cheeserust/final_project/주행파트 일지.md

# 작업 일지 (Work Log)

## 7/6
### 오늘 한 것
1. cpu 오버로드 에러 발견
```
   [component_container_isolated-1] [WARN] [1783338867.642356056] [bt_navigator_navigate_to_pose_rclcpp_node]: Timed out while waiting for action server to acknowledge goal request for compute_path_to_pose
[component_container_isolated-1] [ERROR] [1783338867.663267694] [bt_navigator_navigate_to_pose_rclcpp_node]: Failed to get result for follow_path in node halt!
[component_container_isolated-1] [WARN] [1783338867.663639029] [bt_navigator]: [navigate_to_pose] [ActionServer] Aborting handle.
[component_container_isolated-1] [ERROR] [1783338867.664488179] [bt_navigator]: Goal failed
[component_container_isolated-1] [WARN] [1783338867.671340638] [controller_server]: Control loop missed its desired rate of 20.0000 Hz. Current loop rate is 12.3509 Hz.
[component_container_isolated-1] [INFO] [1783338867.671417620] [controller_server]: Cancellation was successful. Stopping the robot.
[component_container_isolated-1] [INFO] [1783338867.671439212] [controller_server]: [follow_path] [ActionServer] Client requested to cancel the goal. Cancelling.
```
2. 합친 코드 엘리베이터 타는것까지 테스트 완료
3. 파라미터 수정해서 주행 안정화 --> 벽에 붙는 현상 해소

### 내일 할 것
1. 내리는거 시퀀스 수정
2. 코드 최적화

## 7/5
### 오늘 한 것
1. 코드 합쳤다
2. local costmap 뒤집히는 억까 풀려고 했다 근데 못풀었다

### 내일 할 것
1. 코드 full scenario 테스트해보기
2. 하차 marker들 좌표 & yaw값 floor markers에 넣기
3. 디버깅용 로그 넣기 (필요하면)
4. local costmap 계속 뒤집혀있으면 다시 sllidar_ros2 깔아서 해보기

## 7/4
### 지금까지 한것
1. 엘베 하차 후 회전 동작 구현 (살짝 손봐야함)
2. 아르코마커 servoing
3. 층에서 좌표로 navigation 기능 구현

### 할거
1. 코드합치기

## 6/30
### 오늘 한 것
1. pinky_delivery 의 앨베 타고 내리는 로직 수정
2. 맵 스위치 로직 수정 --> map_switcher 가 더이상 카메라를 사용하지 않음, /floor/check 토픽을 구독하고 있다가 맵이 바뀐거 감지되면 교체
3. 빅핑키 1.5층 만들었음
4. 층 주행 패키지 + 층간이동 패키지 코드 합침

### 내일 할 것
1. 합친 코드로 주행 해보기
2. LLM으로 주행 해보기
3. 중앙 서버에 뭐 올려야 하는지 의논

## 6/29
### 오늘 한 것
1. 엘리베이터 문 열리고 닫히고 마커인식해서 cmd_vel 로 주행 하는거 확인
2. 미리 정해놓은 key 좌표로 주행하는거 구현

### 내일 할 것
1. 패키지 만들고 driving flooring 합치기
2. 1.5층 만들기
