cheeserust/final_project/gripper_description/docs/dimensions/finger_dimensions.txt

==========================================
Finger Dimensions
==========================================

Finger Width            : 30.2 mm
Finger Overall Length   : 58.9 mm

Middle Link Length      : 54.0 mm
Middle Link Face Length : 51.0 mm

Finger Tip Length       : 20.0 mm
Finger End Length       : 22.5 mm
Finger Face Length      : 56.4 mm

Bearing Pocket Height   : 3.8 mm
