cheeserust/final_project/gripper_description/docs/dimensions/reference_dimensions.txt

==========================================
Reference Dimensions
==========================================

Finger Tip ↔ End Shaft Distance      : 108.7 mm
Finger Tip ↔ Middle Shaft Distance   : 46.3 mm

Joint Center Distance                : 63.5 mm

Base Offset                          : 27.3 mm

Base Shaft Distance #1               : 80.5 mm
Base Shaft Distance #2               : 80.7 mm
Base Shaft Distance #3               : 81.8 mm
