cheeserust/final_project/imgs/system_architecture.png

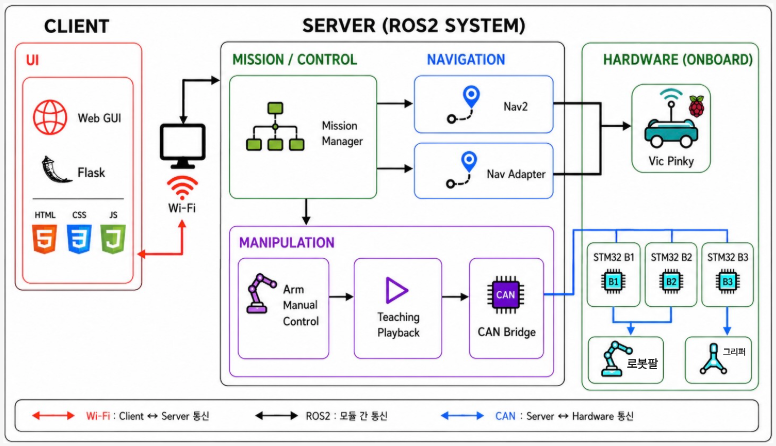
imgs/system_architecture.png
