cheeserust/final_project/gripper_description/meshes/stl/end_effector/link_connecting_part.stl

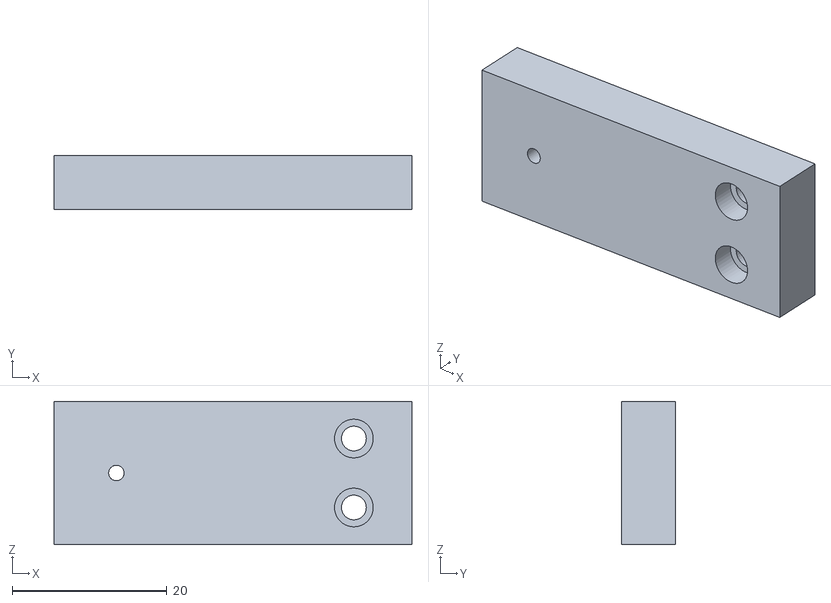
[picture p4: CAD file, 2026-07-07]
gripper_description/meshes/stl/end_effector/link_connecting_part.stl
46.2 x 7.00 x 18.5
