cheeserust/final_project/gripper_description/meshes/stl/shaft/shaft_3mm.stl

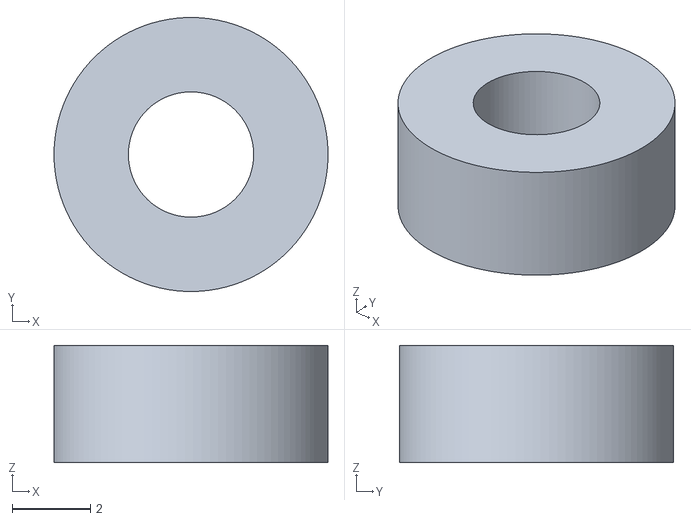
[picture p5: CAD file, 2026-07-07]
gripper_description/meshes/stl/shaft/shaft_3mm.stl
7.00 x 7.00 x 3.00
