cheeserust/final_project/gripper_description/meshes/stl/stm_case/NUCLEO-L476RG-Housing-V2.stl

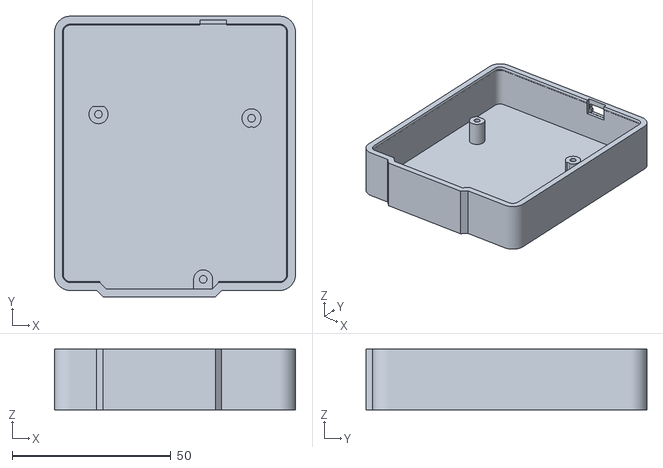
[picture p6: CAD file, 2026-07-09]
gripper_description/meshes/stl/stm_case/NUCLEO-L476RG-Housing-V2.stl
76.0 x 88.5 x 19.1
