cheeserust/final_project/gripper_description/meshes/stl/end_effector/bot_place_mini.stl

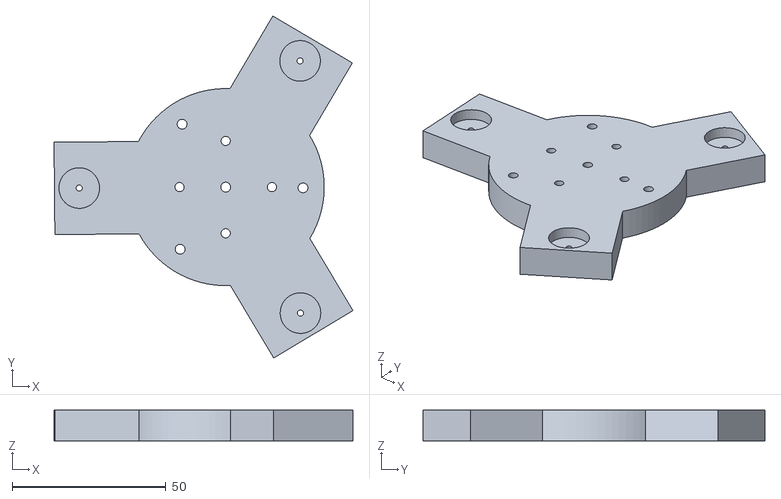
[picture p7: CAD file, 2026-07-07]
gripper_description/meshes/stl/end_effector/bot_place_mini.stl
97.1 x 111.1 x 10.0
