cheeserust/final_project/gripper_description/meshes/stl/shaft/shaft_4mm.stl

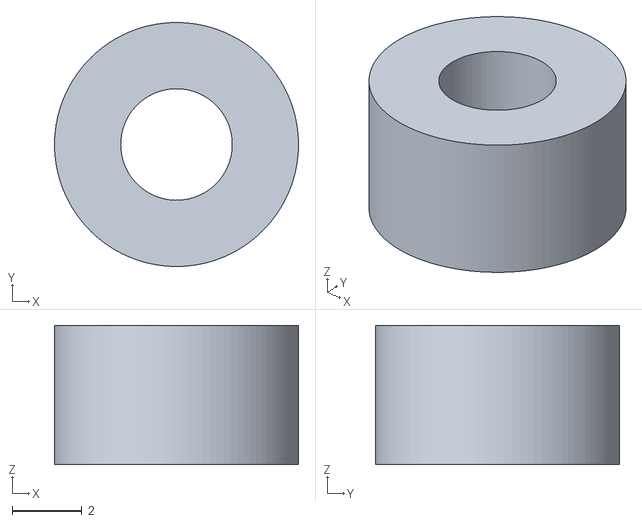
[picture p8: CAD file, 2026-07-07]
gripper_description/meshes/stl/shaft/shaft_4mm.stl
7.00 x 7.00 x 4.00
