cheeserust/final_project/gripper_description/meshes/stl/end_effector/finger1_link_1.stl

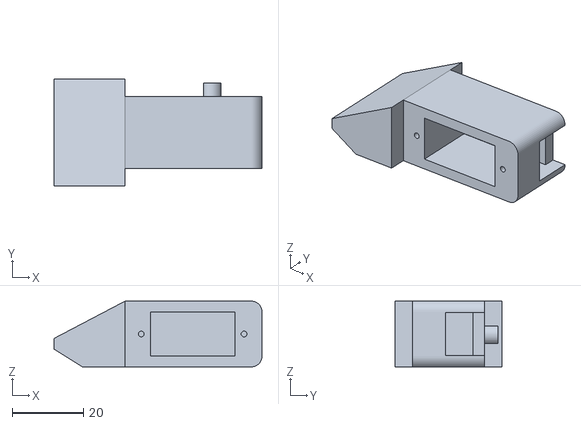
[picture p10: CAD file, 2026-07-07]
gripper_description/meshes/stl/end_effector/finger1_link_1.stl
58.4 x 30.2 x 18.5
