cheeserust/final_project/gripper_description/meshes/stl/shaft/shaft_6mm.stl

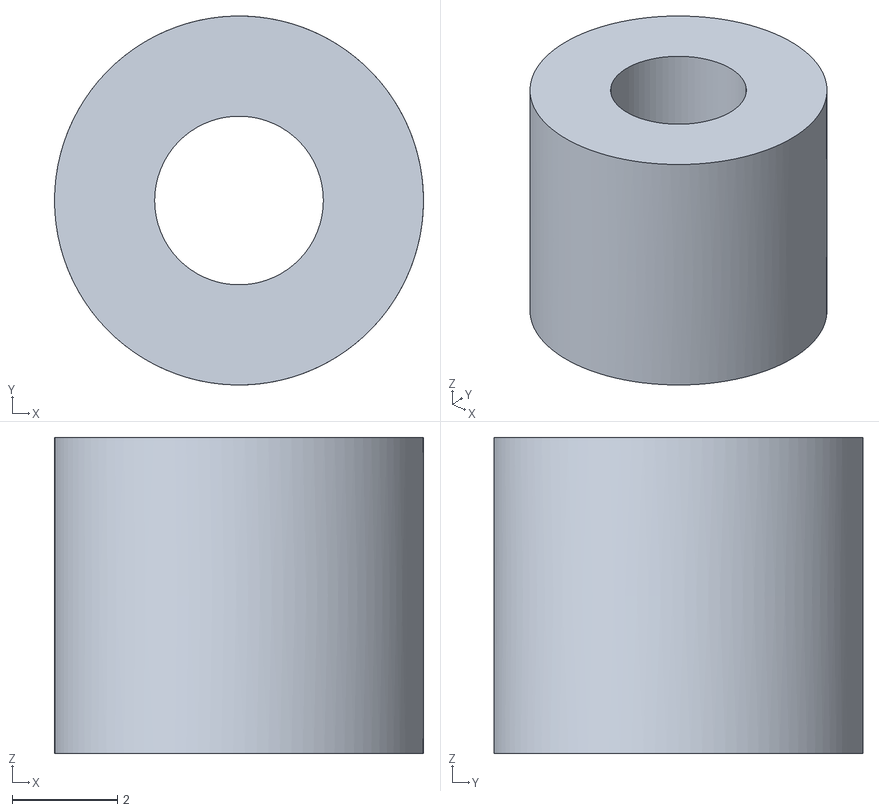
[picture p11: CAD file, 2026-07-07]
gripper_description/meshes/stl/shaft/shaft_6mm.stl
7.00 x 7.00 x 6.00
