cheeserust/final_project/gripper_description/meshes/stl/end_effector/left_fix.stl

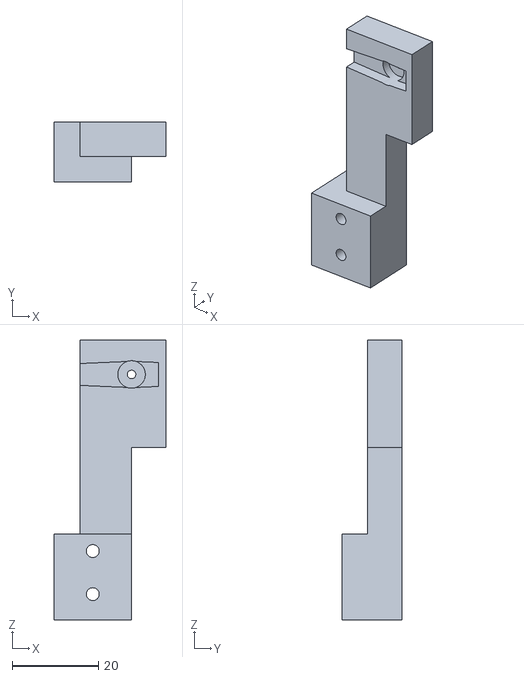
[picture p12: CAD file, 2026-07-07]
gripper_description/meshes/stl/end_effector/left_fix.stl
26.0 x 14.0 x 65.0
