cheeserust/final_project/gripper_description/meshes/stl/shaft/shaft_5mm.stl

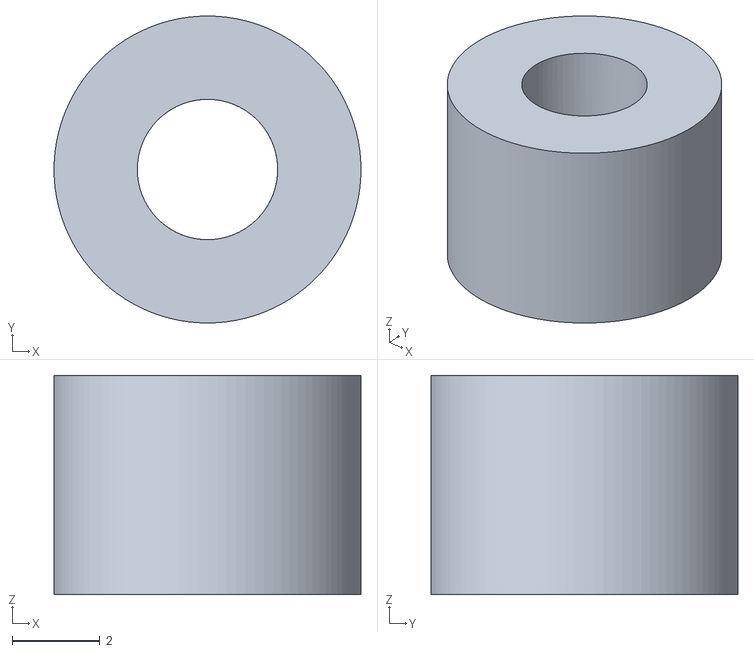
[picture p13: CAD file, 2026-07-07]
gripper_description/meshes/stl/shaft/shaft_5mm.stl
7.00 x 7.00 x 5.00
