cheeserust/final_project/gripper_description/meshes/stl/shaft/shaft_7mm.stl

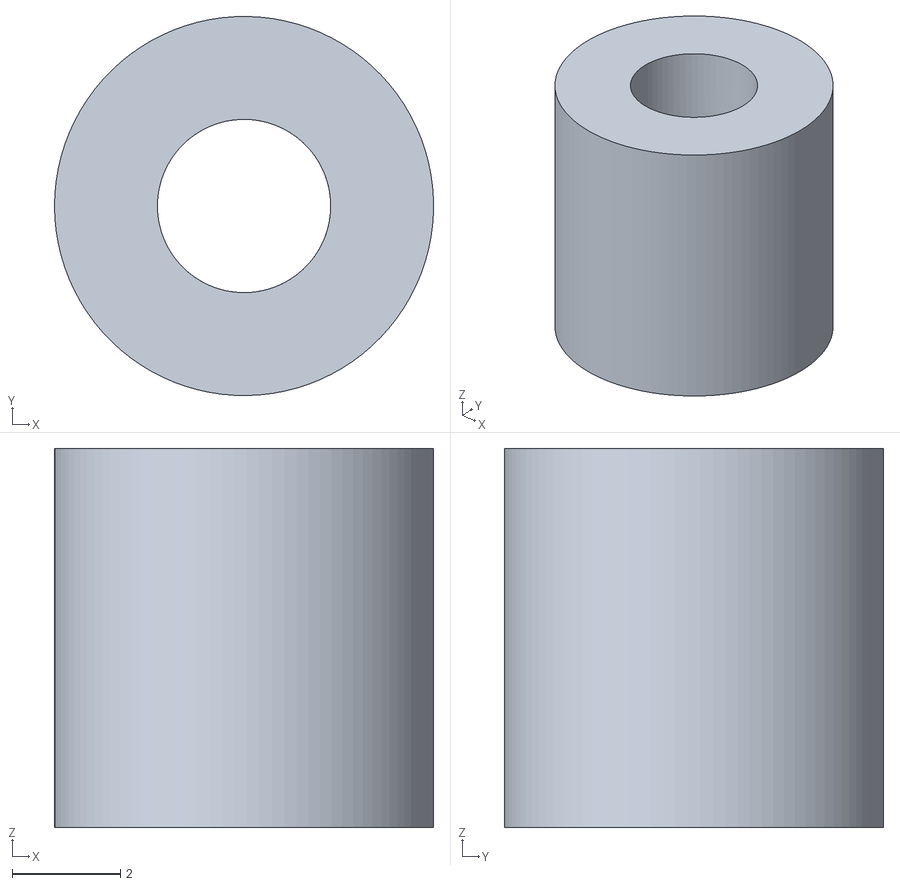
[picture p14: CAD file, 2026-07-07]
gripper_description/meshes/stl/shaft/shaft_7mm.stl
7.00 x 7.00 x 7.00
