cheeserust/final_project/gripper_description/meshes/stl/end_effector/right_fix.stl

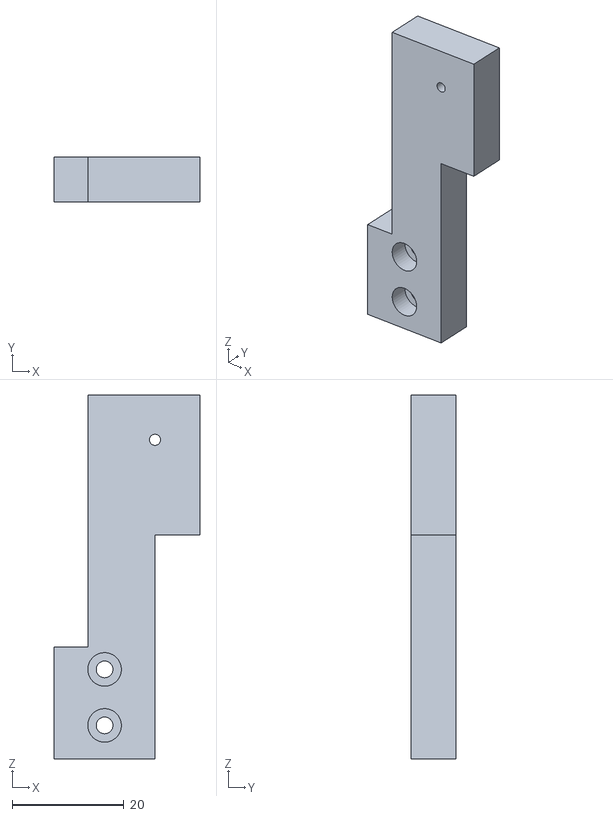
[picture p15: CAD file, 2026-07-07]
gripper_description/meshes/stl/end_effector/right_fix.stl
26.0 x 8.00 x 65.0
