cheeserust/final_project/gripper_description/meshes/stl/end_effector/finger1_link_2.stl

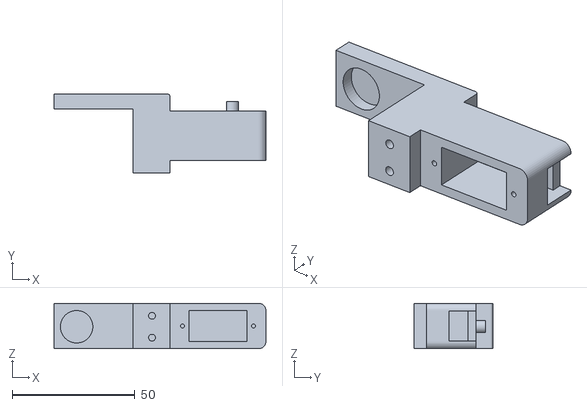
[picture p16: CAD file, 2026-07-07]
gripper_description/meshes/stl/end_effector/finger1_link_2.stl
86.2 x 32.0 x 18.5
