cheeserust/final_project/gripper_description/meshes/stl/end_effector/body.stl

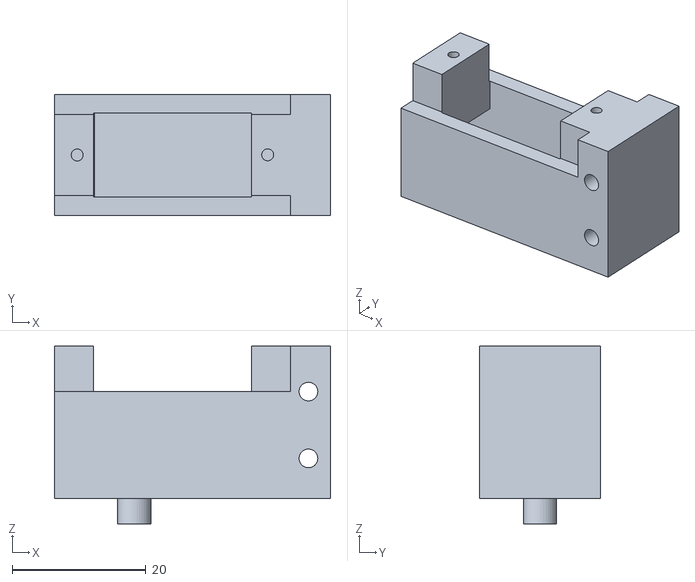
[picture p17: CAD file, 2026-07-07]
gripper_description/meshes/stl/end_effector/body.stl
41.3 x 18.1 x 26.6
