cheeserust/final_project/(list of files, cad)

Other CAD files:
gripper_description/meshes/stl/end_effector/bot_place_fix.stl
gripper_description/meshes/stl/end_effector/top_place_mini.stl
