cheeserust/final_project/src/arm_can_bridge/config/arm_can_bridge.yaml

arm_can_bridge:
  ros__parameters:
    # 개발 중에는 vcan0, 실제 STM32 연결 시 can0으로 변경한다.
    can_interface: "vcan0"

    # MoveIt controller 설정과 정확히 맞아야 하는 Action 이름이다.
    arm_action_name: "/arm_controller/follow_joint_trajectory"
    gripper_action_name: "/gripper_controller/follow_joint_trajectory"

    # RViz/robot_state_publisher가 읽는 joint state topic이다.
    # 0x301/0x302/0x303 actual feedback이 있으면 실제값을 우선 사용한다.
    joint_states_topic: "/joint_states"

    # Arm controller: Board1 4축 step motor + Board2 1축 step motor.
    # 전력 분산을 위해 base_joint는 Board2, arm_joint_1~4는 Board1이 담당한다.
    arm_joint_names:
      - "base_joint"
      - "arm_joint_1"
      - "arm_joint_2"
      - "arm_joint_3"
      - "arm_joint_4"

    # arm_joint_names와 같은 인덱스 순서로 대응한다.
    # Board2: base_joint
    # Board1: arm_joint_1~arm_joint_4
    arm_board_ids: [2, 1, 1, 1, 1]
    arm_motor_ids: [0, 0, 1, 2, 3]

    # 실제 구동 전 MoveIt URDF/joint_limits.yaml 값과 동일해야 한다.
    arm_min_positions_rad:
      - -1.57079633   # base_joint: -90 deg
      - -1.57079633   # arm_joint_1: -90 deg
      - -1.39626340   # arm_joint_2: -80 deg
      - -1.57079633   # arm_joint_3: -90 deg
      - -2.96705973   # arm_joint_4: -170 deg

    arm_max_positions_rad:
      - 3.14159265    # base_joint: 180 deg
      - 1.57079633    # arm_joint_1: 90 deg
      - 1.39626340    # arm_joint_2: 80 deg
      - 1.57079633    # arm_joint_3: 90 deg
      - 2.96705973    # arm_joint_4: 170 deg

    # homing 완료 후 /joint_states에 표시할 arm commanded home pose다.
    arm_home_positions_rad:
      - -1.57079633   # base_joint home: -90 deg
      - -1.57079633   # arm_joint_1 home: -90 deg
      - -1.39626340   # arm_joint_2 home: -80 deg
      - -1.57079633   # arm_joint_3 home: -90 deg
      - -2.96705973   # arm_joint_4 home: -170 deg

    # Gripper controller: Board3 9축 servo.
    gripper_joint_names:
      - "finger_1_base_joint"
      - "finger_1_middle_joint"
      - "finger_1_tip_joint"
      - "finger_2_base_joint"
      - "finger_2_middle_joint"
      - "finger_2_tip_joint"
      - "finger_3_base_joint"
      - "finger_3_middle_joint"
      - "finger_3_tip_joint"

    # gripper_joint_names와 같은 인덱스 순서로 대응한다.
    gripper_board_ids: [3, 3, 3, 3, 3, 3, 3, 3, 3]
    gripper_motor_ids: [0, 1, 2, 3, 4, 5, 6, 7, 8]

    gripper_min_positions_rad:
      - -1.22696646   # finger_1_base_joint: -70.3 deg
      - -2.40331838   # finger_1_middle_joint: -137.7 deg
      - -1.94255146   # finger_1_tip_joint: -111.3 deg
      - -1.22696646   # finger_2_base_joint: -70.3 deg
      - -2.40331838   # finger_2_middle_joint: -137.7 deg
      - -1.94255146   # finger_2_tip_joint: -111.3 deg
      - -1.22696646   # finger_3_base_joint: -70.3 deg
      - -2.40331838   # finger_3_middle_joint: -137.7 deg
      - -1.94255146   # finger_3_tip_joint: -111.3 deg

    gripper_max_positions_rad:
      - 1.22696646    # finger_1_base_joint: 70.3 deg
      - 0.91978852    # finger_1_middle_joint: 52.7 deg
      - 1.94255146    # finger_1_tip_joint: 111.3 deg
      - 1.22696646    # finger_2_base_joint: 70.3 deg
      - 0.91978852    # finger_2_middle_joint: 52.7 deg
      - 1.94255146    # finger_2_tip_joint: 111.3 deg
      - 1.22696646    # finger_3_base_joint: 70.3 deg
      - 0.91978852    # finger_3_middle_joint: 52.7 deg
      - 1.94255146    # finger_3_tip_joint: 111.3 deg

    # Board3는 homing 대신 ready/fault status만 본다. home pose는 host estimate 기준이다.
    gripper_home_positions_rad:
      - 0.0
      - 0.0
      - 0.0
      - 0.0
      - 0.0
      - 0.0
      - 0.0
      - 0.0
      - 0.0

    # Firmware 초기 버전에서는 Speed를 보간에 사용하지 않으므로 0으로 보낸다.
    speed_raw: 0

    # 0x201/0x202/0x203 상태가 이 시간보다 오래 들어오지 않으면 연결 이상으로 본다.
    status_timeout_ms: 500

    # 각 STM32 firmware queue 전체 slot 수다.
    queue_capacity: 32

    # Queue slot이 부족할 때 기다릴 최대 시간이다.
    queue_wait_timeout_ms: 3000

    # 마지막 frame 송신 후 예상 종료 시각을 넘겨 추가로 기다릴 시간이다.
    completion_grace_ms: 3000

    # Board1의 axis 0~3 homing 완료 mask다. Board2는 코드에서 bit0을 사용한다.
    required_homing_mask: 15

    # time_from_start=0인 첫 point가 현재 추정 위치와 같다고 볼 허용 오차다.
    start_position_tolerance_rad: 0.02

    # /joint_states 발행 주기다.
    joint_state_rate_hz: 50.0

    control_wait_timeout_ms: 3000
    status_publish_period_ms: 500
