cheeserust/final_project/roscue_arm/Core/Inc/stepper.h

#ifndef STEPPER_H
#define STEPPER_H

#include "config.h"

void stepper_init(void);
void stepper_stop_axis(uint8_t id);
void stepper_stop_all(void);
void stepper_prepare_motion(uint16_t duration_ms);
void stepper_cancel_motion(void);
void stepper_start_homing(uint8_t id);
void stepper_start_homing_all(void);
void stepper_10us_interrupt(void);
void stepper_1ms_interrupt(void);
void stepper_homing_1ms(void);
uint8_t stepper_limit_switch_status_bits(void);

#endif
