cheeserust/final_project/gripper_firmware/gripper_firmware_0708/clock.c

#include "device_driver.h"

void Clock_Init(void)
{
    RCC->CR |= (1 << 0); 
    while(!Macro_Check_Bit_Set(RCC->CR, 1));

    FLASH->ACR = (1<<12)|(1<<11);
    FLASH->ACR = (1<<10)|(1<<9)|(1<<8)|(0x3 << 0);

    RCC->PLLCFGR = (8<<24)|(0<<22)|(1<<16)|(192<<6)|(8<<0);

    Macro_Set_Bit(RCC->CR, 24);
    while(!Macro_Check_Bit_Set(RCC->CR, 25));

    RCC->CFGR = (0<<13)|(4<<10)|(0<<4);

    Macro_Write_Block(RCC->CFGR, 0x3, 0x2, 0);
    while(Macro_Extract_Area(RCC->CFGR, 0x3, 2) != 0x2);
}
