cheeserust/final_project/gripper_firmware/gripper_firmware_0708/exception.c

#include "device_driver.h"
#include <stdio.h>

void _Invalid_ISR(void)
{
	unsigned int r = Macro_Extract_Area(SCB->ICSR, 0x1ff, 0);
	printf("\nInvalid_Exception: %d!\n", r);
	printf("Invalid_ISR: %d!\n", r - 16);
	for(;;);
}
