cheeserust/final_project/(commit log)

2026-06-29 Add VicPinky server GUI and elevator FSM flow
    [Untitled.ros2_control.xacro, Untitled.urdf.xacro, finger_1_base_link.urdf.xacro, finger_1_middle_link.urdf.xacro, finger_1_tip_link.urdf.xacro, finger_2_base_link.urdf.xacro, finger_2_middle_link.urdf.xacro, finger_2_tip_link.urdf.xacro]
2026-07-01 Update arm CAN bridge trajectory and feedback handling
2026-07-07 Update 주행파트 일지.md
2026-07-07 Add gripper_description package
    [body.stl, bot_place_fix.stl, bot_place_mini.stl, f_low_body_1.stl, f_upper_body_1.stl, f_upper_body_2.stl, finger1_link_1.stl, finger1_link_2.stl]
2026-07-08 Add: 펌웨어 코드 및 관련 하위 폴더 추가
2026-07-09 Update STL File Sources
    [NUCLEO-L476RG-Housing-Lid-V2.stl, NUCLEO-L476RG-Housing-V2.stl, f_low_body_1.stl, f_upper_body_1.stl, f_upper_body_2.stl]
2026-07-11 로봇팔 코드 추가
